Bobrowicz/battery-logger/README.md

# battery-logger
Repository for my digitally controlled dummy load/battery tester
