Bobrowicz/battery-logger/battery logger.kicad_pcb

## KiCad design battery logger.kicad_pcb (2015-03-27)

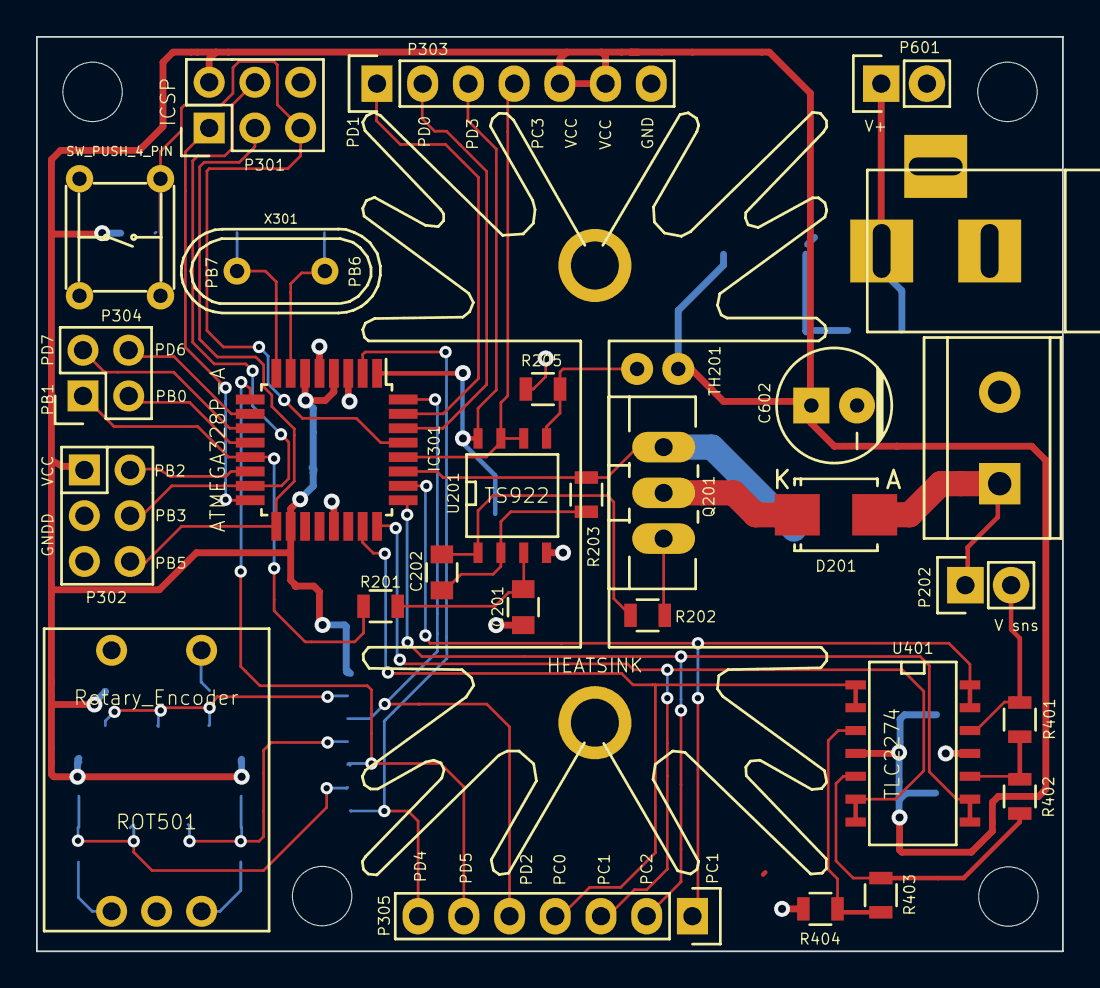
[picture p1: board battery logger.kicad_pcb from above]

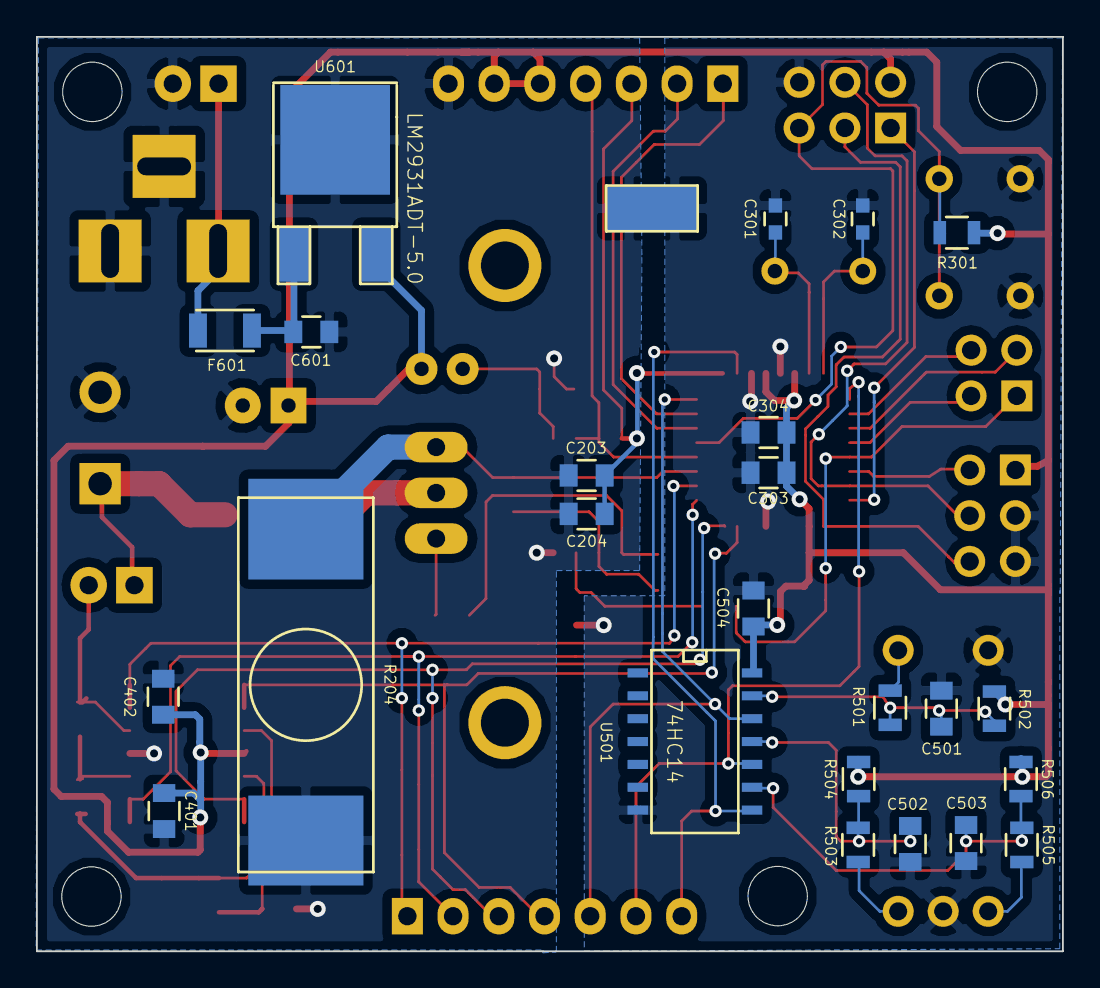
[picture p2: board battery logger.kicad_pcb from below]

Board: 2 copper layers, 57.0 x 50.8 mm, 59 parts (25 on the bottom side), 45 nets.

Parts:
C201, C202, C203, C402, C501: 1u; C_0805
C204, C303, C401, C504, C601: 0.1u; C_0805
C301, C302: 18p; C_0603
C304, C502, C503: 0.01u; C_0805
C602: 100u; Capacitor6.4x6RM2.5
CON601: BARREL_JACK
D201: DIODESCH; Diode-SMB_Standard
F601: FUSE; PTC_1206
HS201: HEATSINK; FA-TO220-64E
IC301: ATMEGA328P-A; TQFP-32_7x7mm_Pitch0.8mm
J601: Net_Tie; Net_Tie2
M3 screw hole, M3 screw hole#2, M3 screw hole#3, M3 screw hole#4: VAL**; M3_screw_hole
P201: CONN_01X02; Terminal_Block_1x2_5.08mm
P202, P601: CONN_01X02; Pin_Header_Straight_1x02
P301, P302: CONN_02X03; Pin_Header_Straight_2x03
P303, P305: CONN_01X07; Pin_Header_Straight_1x07
P304: CONN_02X02; Pin_Header_Straight_2x02
Q201: BUK9575; TO-220_FET-GDS_Vertical_LargePads
R201, R203, R205, R301, R401, R502, R504, R506: 10k; R_0805
R202: 100R; R_0805
R204: 1R; 8035_J-Lead
R402, R403, R404, R501, R503, R505: 3.3k; R_0805
ROT501: Rotary_Encoder; PEC11R
SW301: SW_PUSH_4_PIN; B3F-10XX
TH201: THERMISTOR; SolderWirePad_2x_0-8mmDrill
U201: TS922; SOIC-8-N
U401: TLC2274; SOIC-14_N
U501: 74HC14; SOIC-14_N
U601: LM2931ADT-5.0; DPAK-2
X301: CRYSTAL 16MHZ; Crystal_HC49-U_Vertical

Connections:
/Current Sink/AUX: IC301.28, P303.4, U201.6, U201.7
/Current Sink/BATT_V: P202.2, R401.1, U401.12
/Current Sink/ENABLE: C203.1, C204.1, IC301.1, P303.3, U201.8
/Current Sink/I_SNS: IC301.27, Q201.S, R203.1, R204.1
/Current Sink/V_SET: IC301.13, P304.1, R201.1
/Encoder Interface/ENC_A: IC301.2, P305.7, U501.8
/Encoder Interface/ENC_B: IC301.9, P305.6, U501.10
/Encoder Interface/ENC_SW: IC301.32, P305.5, U501.12
/Input Voltage Range Switch/V_SNS1: IC301.26, P305.1, U401.13, U401.14
/Input Voltage Range Switch/V_SNS2: IC301.25, P305.2, U401.8, U401.9
/Input Voltage Range Switch/V_SNS3: IC301.24, P305.3, U401.6, U401.7
/Input Voltage Range Switch/V_SNS4: IC301.23, P305.4, U401.1, U401.2
/Voltage Regulator/Vs: CON601.1, F601.1, P601.1
/uController/CLK: IC301.17, P301.3, P302.6
/uController/DAT: IC301.15, P301.4, P302.4
/uController/LAT: IC301.14, P302.2
/uController/MISO: IC301.16, P301.1
/uController/PB0: IC301.12, P304.3
/uController/PB6: C301.1, IC301.7, X301.1
/uController/PB7: C302.1, IC301.8, X301.2
/uController/PC6: IC301.29, P301.5, R301.2, SW301.1, SW301.4
/uController/PD0: IC301.30, P303.2
/uController/PD1: IC301.31, P303.1
/uController/PD6: IC301.10, P304.4
/uController/PD7: IC301.11, P304.2
GND: C203.2, C204.2, C401.2, C402.2, C601.2, C602.2, CON601.2, CON601.3, J601.1, P201.2, P303.7, P601.2, R204.2, R205.1, R404.2, U201.4, U401.11, U601.2
GNDD: C201.2, C301.2, C302.2, C303.2, C304.2, C501.2, C502.2, C503.2, C504.2, IC301.3, IC301.5, IC301.21, J601.2, P301.6, P302.3, P302.5, ROT501.1, ROT501.4, SW301.2, SW301.3, U501.7
unnamed: C201.1, R201.2, U201.3
unnamed: C202.1, R202.2, U201.1
unnamed: C202.2, R203.2, U201.2
unnamed: C501.1, R501.1, R502.2, U501.13
unnamed: C502.1, R503.1, R504.2, U501.11
unnamed: C503.1, R505.2, R506.2, U501.9
unnamed: C601.1, F601.2, U601.1
unnamed: D201.1, P201.1, P202.1
unnamed: D201.2, Q201.D
unnamed: Q201.G, R202.1
unnamed: R205.2, TH201.2, U201.5
unnamed: R401.2, R402.1, U401.10
unnamed: R402.2, R403.1, U401.5
unnamed: R403.2, R404.1, U401.3
unnamed: R501.2, ROT501.2
unnamed: R503.2, ROT501.5
unnamed: R505.1, ROT501.3
VCC: C303.1, C304.1, C401.1, C402.1, C504.1, C602.1, IC301.4, IC301.6, IC301.18, P301.2, P302.1, P303.5, P303.6, R301.1, R502.1, R504.1, R506.1, TH201.1, U401.4, U501.14, U601.3
