Bobrowicz/battery-logger/(commit log)

2015-02-10 initial schematic with tentative components
    [battery logger.sch]
2015-02-10 added arduino code
2015-02-10 added few parts to schematic
    [battery logger.sch]
2015-02-12 added LCD connections
    [battery logger.sch]
2015-02-13 added hierarchical sheets
    [CurrentSink.sch, VoltageRegulator.sch, battery logger.sch, uController.sch]
2015-02-13 more cleanup
    [CurrentSink.sch, VoltageRegulator.sch, battery logger.sch]
2015-02-17 updated schematic
    [CurrentSink.sch, InputVoltageRangeSwitch.sch, VoltageRegulator.sch, battery logger.sch, uController.sch]
2015-02-22 beginning layout
    [CurrentSink.sch, EncoderInterface.sch, InputVoltageRangeSwitch.sch, VoltageRegulator.sch, battery logger.kicad_pcb, battery logger.sch, uController.sch]
2015-02-22 initial part placemen
    [CurrentSink.sch, EncoderInterface.sch, InputVoltageRangeSwitch.sch, VoltageRegulator.sch, battery logger.kicad_pcb, battery logger.sch, uController.sch]
2015-02-24 tweaking part layout
    [CurrentSink.sch, EncoderInterface.sch, battery logger.kicad_pcb, uController.sch]
2015-03-02 finished layout
    [CurrentSink.sch, EncoderInterface.sch, InputVoltageRangeSwitch.sch, VoltageRegulator.sch, battery logger.kicad_pcb, battery logger.sch, uController.sch]
2015-03-02 minor tweaks
    [CurrentSink.sch, EncoderInterface.sch, InputVoltageRangeSwitch.sch, VoltageRegulator.sch, battery logger.kicad_pcb, uController.sch]
2015-03-07 generated gerber files
    [battery logger-B_Cu.gbl, battery logger-B_Mask.gbs, battery logger-B_SilkS.gbo, battery logger-Edge_Cuts.gbr, battery logger-F_Cu.gtl, battery logger-F_Mask.gts, battery logger-F_SilkS.gto, battery logger.drl]
2015-03-14 BOM update
    [CurrentSink.sch, EncoderInterface.sch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]
2015-03-27 schematic correction
    [EncoderInterface.sch, battery logger.csv, battery logger.kicad_pcb]
2015-04-06 cleaned up some code and added component footprints
2015-04-09 minor code change
    tested simplified version of the code for scrolling through menu using
    rotary encoder.
    started working to calibration function
2015-04-18 some progress on calibration function
2015-04-24 committing in case i mess up what im doing
